hrobry/System_Analityczno-Predykcyjny/Core/Src/main.c

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
/* Includes ------------------------------------------------------------------*/
#include "main.h"
#include "i2c.h"
#include "lwip.h"
#include "usb_otg.h"
#include "gpio.h"

/* USER CODE BEGIN Includes */
#include "lwip/udp.h"
#include "adxl345.h"
#include <string.h>
#include <stdio.h>
#include "lwip/apps/sntp.h"
#include "lwip/ip_addr.h"
//#include <rtc.h>     // CubeMX wygenerowane pliki RTC
#include <time.h>
/* USER CODE END Includes */


void SystemClock_Config(void);
/* USER CODE BEGIN 0 */
extern I2C_HandleTypeDef hi2c1;
struct udp_pcb *udp;
ip_addr_t dest_ip;
uint16_t dest_port = 5005;
typedef struct {
    int16_t x_offset;
    int16_t y_offset;
    int16_t z_offset;
} CalibrationData;

CalibrationData calib = {0, 0, 0};

void calibrate_adxl345(void) {
    // Połóż akcelerometr na płaskiej powierzchni
    int32_t sum_x = 0, sum_y = 0, sum_z = 0;
    const int samples = 100;

    for(int i = 0; i < samples; i++) {
        int16_t x, y, z;
        ADXL345_ReadXYZ(&hi2c1, &x, &y, &z);
        sum_x += x;
        sum_y += y;
        sum_z += z;
        HAL_Delay(10);
    }

    // Oblicz offset - Z powinno pokazywać ~1g (256)
    calib.x_offset = sum_x / samples;
    calib.y_offset = sum_y / samples;
    calib.z_offset = (sum_z / samples) - 256; // Odejmij 1g

    printf("Kalibracja: X=%d, Y=%d, Z=%d\n",
           calib.x_offset, calib.y_offset, calib.z_offset);
}
void UDP_Init(void)
{
    udp = udp_new();
    IP4_ADDR(&dest_ip, 3,53,17,22); // <-- tu wpisz adres PC odbierającego dane 3.53.17.22 ///192,168,0,102
    udp_bind(udp, IP_ADDR_ANY, 5005); // port źródłowy
}
void sendMessageToRasp(int x, int y , int z)
{
         char msg[64];
         int len = sprintf(msg, " dane jakie wysyłam to  : %d,%d,%d", x, y, z);

         struct pbuf *p = pbuf_alloc(PBUF_TRANSPORT, len, PBUF_RAM);
         memcpy(p->payload, msg, len);
         udp_sendto(udp, p, &dest_ip, dest_port);
         pbuf_free(p);

}


/* USER CODE END 0 */

/**
  * @brief  The application entry point.
  * @retval int
  */
int main(void)
{

  /* MCU Configuration--------------------------------------------------------*/

  /* Reset of all peripherals, Initializes the Flash interface and the Systick. */
  HAL_Init();

  /* USER CODE BEGIN Init */
  HAL_Delay(500);

  // W main użyj skorygowanych wartości

  /* USER CODE END Init */

  /* Configure the system clock */
  SystemClock_Config();

  /* Initialize all configured peripherals */
  MX_GPIO_Init();
  MX_USB_OTG_FS_PCD_Init();
  MX_I2C1_Init();
  MX_LWIP_Init();
  /* USER CODE BEGIN 2 */

  ///StartNTP();     // uruchamia klienta NTP
  HAL_GPIO_WritePin(GPIOG, GPIO_PIN_6, GPIO_PIN_RESET);

  UDP_Init();
  const char *  ajpi;
  extern struct netif gnetif;
  ADXL345_Init(&hi2c1);
  for (int i = 0; i < 40; ++i) { // ~20s jeśli delay 500ms
             MX_LWIP_Process();
             if (gnetif.ip_addr.addr != 0) break;
             HAL_Delay(500);
         }

         // Wypisz IP na UART (jeśli printf skonfigurowany)
         {
             ip_addr_t ip = gnetif.ip_addr;
             if (ip.addr != 0) {
                 printf("Assigned IP: %s\r\n", ipaddr_ntoa(&ip));
                 ajpi = ipaddr_ntoa(&ip);
             } else {
                 printf("No IP assigned (DHCP failed)\r\n");
             }
         }
   int16_t x, y, z;
  // sendMessageToRasp(1,2,3); //Debug
   while (1)
   {

       MX_LWIP_Process(); // cubeMX wygenerowało - potrzebne w pętli
     //  sendMessageToRasp(1,1,1); // Debug

       GPIO_PinState state1 = HAL_GPIO_ReadPin(GPIOC,GPIO_PIN_9);

       if (state1!=GPIO_PIN_SET)
       {
         calibrate_adxl345();
       }
       if (ADXL345_ReadXYZ(&hi2c1, &x, &y, &z))
       {

    	       // Zastosuj kalibrację
    	       x -= calib.x_offset;
    	       y -= calib.y_offset;
    	       z -= calib.z_offset;

    	       HAL_GPIO_WritePin(GPIOG, GPIO_PIN_6, GPIO_PIN_RESET);

    	   //sendMessageToRasp(3,2,1);//Debug
           char msg[32];
           int len = sprintf(msg, " %d, %d, %d", x, y, z);
           struct pbuf *p = pbuf_alloc(PBUF_TRANSPORT, len, PBUF_RAM);
           memcpy(p->payload, msg, len);
           udp_sendto(udp, p, &dest_ip, dest_port);
           pbuf_free(p);

       }


       HAL_Delay(10); // ~50Hz
   }
  /* USER CODE END 2 */

  /* Infinite loop */
}

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
